UniversalOverlord/FruVendMach/(commit log)

2022-05-25 Create Arduino Info.md
2022-05-25 Rename Arduino Info.md to README.md
